Makerspace-Ashoka/plotter/README.md

# Building a Pen Plotter

Refer to the [blog here.](https://shivamkedia17.github.io/plotter)

This repo contains:
- stepper + driver + CNC shield test code, 
- CAD files (STEP + STL)
- CAD references (obtained from GrabCAD)
- [List of Parts](parts_list.md)
