Makerspace-Ashoka/plotter/index.md

---
title: Plotter Assembly
<!-- layout: base -->
---

Please refer to the relevant sections below:
- [Assembly Walkthrough](tutorial.md)
- [Hurdles](roadblocks.md)
- [What I did & what I learnt](reasoning.md)

# Video Demo

[Here's how](https://youtu.be/HApuH0hwS18) the machine looks when writing a simple G-Code file containing "abc 123 ABC".

# Build Timelapse
Here's a timelapse stitched together to cover almost the entire assembly process. I ended up not recording the parts where I had to troubleshoot, simply because I was trying to figure out what was going wrong.

Please find the [video here](https://youtu.be/O-tHqOsZ5go).
