Makerspace-Ashoka/plotter/cad-references/arduino-129.snapshot.11/Arduino Uno R3 Italy - Bottom view.png

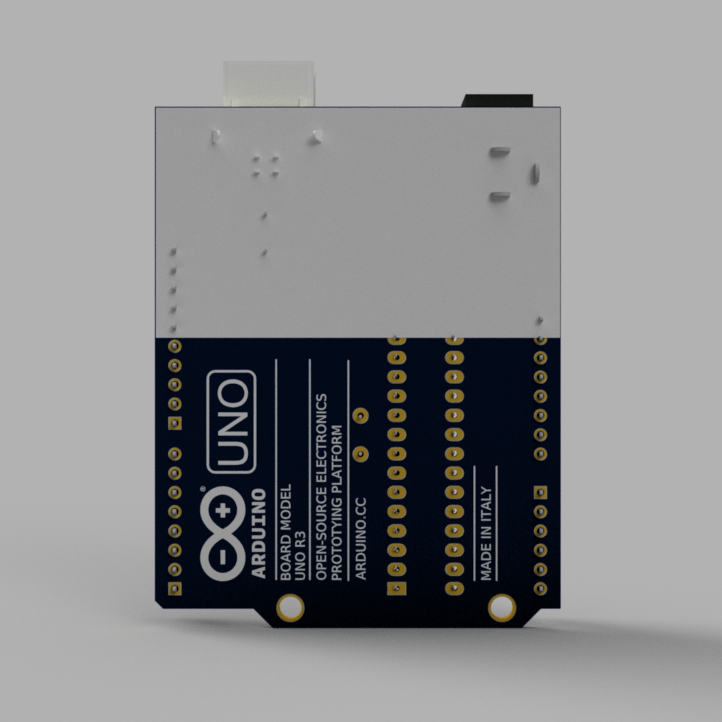
cad-references/arduino-129.snapshot.11/Arduino Uno R3 Italy - Bottom view.png
