Makerspace-Ashoka/plotter/cad-references/arduino-129.snapshot.11/ARDUINO-UNO-R3.png

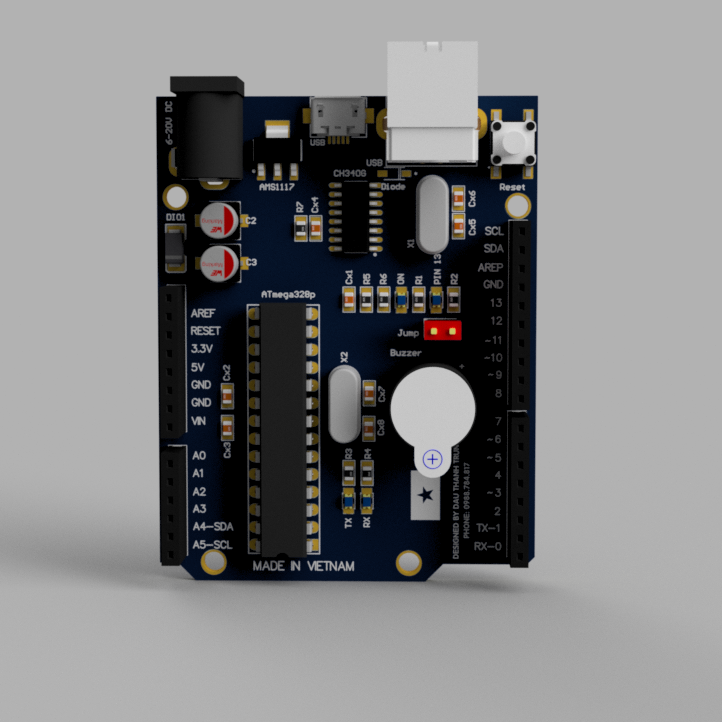
cad-references/arduino-129.snapshot.11/ARDUINO-UNO-R3.png
