Makerspace-Ashoka/plotter/cad-references/nema-17-1-1-scale-1.snapshot.3/c1f0ca76-238e-4594-b3d4-8ab40a781ef2.PNG

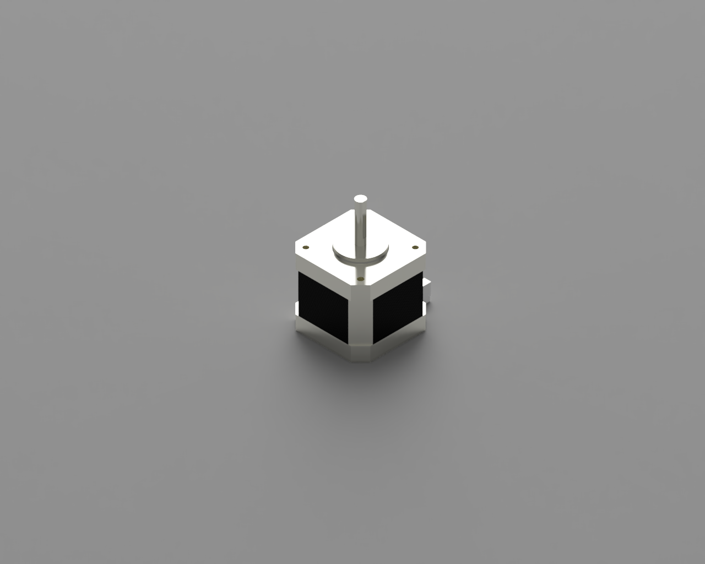
cad-references/nema-17-1-1-scale-1.snapshot.3/c1f0ca76-238e-4594-b3d4-8ab40a781ef2.PNG
