Makerspace-Ashoka/plotter/cad-references/nema-17-1-1-scale-1.snapshot.3/Nema_17_11_2024-Feb-22_08-42-41PM-000_CustomizedView2567685972.png

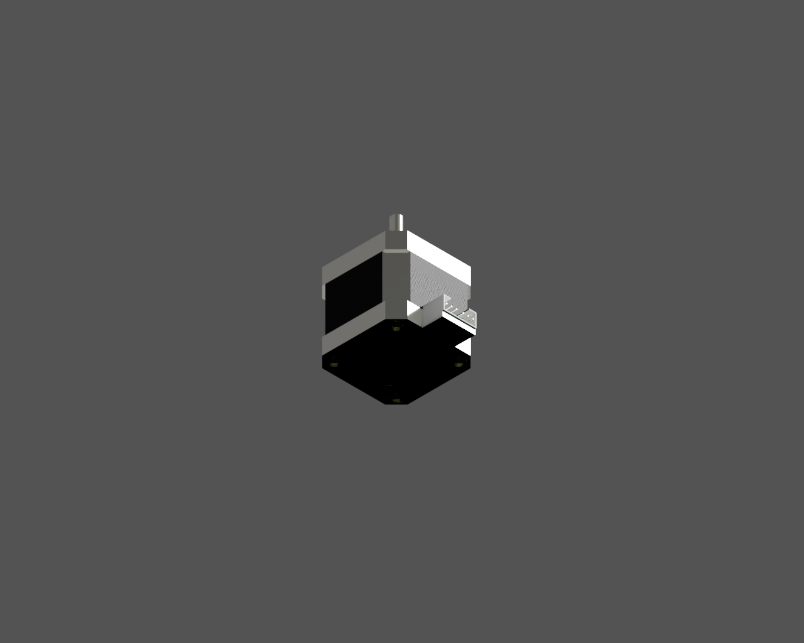
cad-references/nema-17-1-1-scale-1.snapshot.3/Nema_17_11_2024-Feb-22_08-42-41PM-000_CustomizedView2567685972.png
