Makerspace-Ashoka/plotter/cad-references/nema-17-1-1-scale-1.snapshot.3/Screenshot 2024-02-22 154305.png

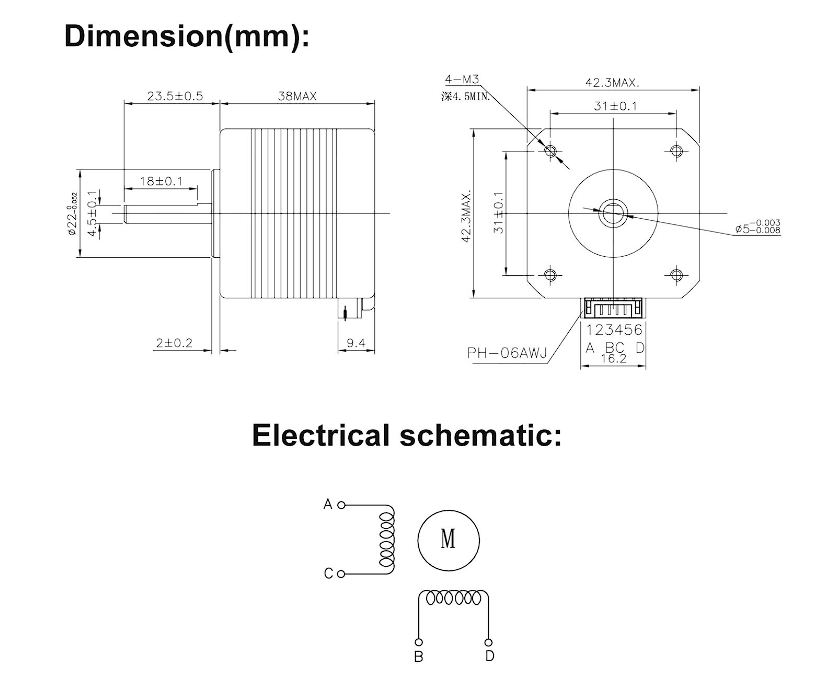
cad-references/nema-17-1-1-scale-1.snapshot.3/Screenshot 2024-02-22 154305.png
