Makerspace-Ashoka/plotter/photos/blog-bg.jpeg

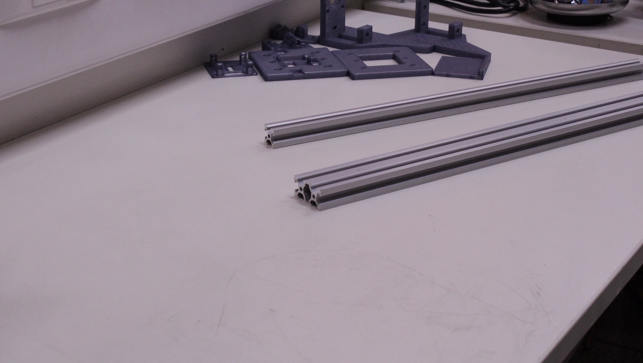
photos/blog-bg.jpeg
