Makerspace-Ashoka/plotter/cad-references/gantry-assembly-1.snapshot.1/Gantry Assembly v6.step

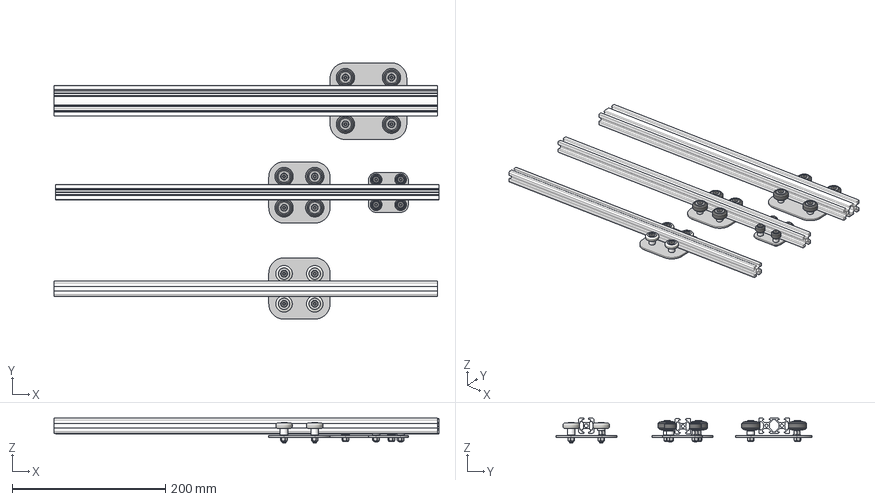
[picture p12: CAD file, 2024-05-11]
cad-references/gantry-assembly-1.snapshot.1/Gantry Assembly v6.step
502.0 x 334.2 x 32.5 mm
Nylon Insert Lock Nut M5 (1) (1) x 16
Aluminum Spacer 6mm (1) (1) (1) x 6
Precision Shim 8 x 5 x 1 (1) (1) x 16
Solid V Wheel (1) (1) x 8
Ball Bearing 5 x 16 x 5 (2) (1) x 8
Precision Shim 10 x 5 x 1 (1) (1) x 8
Ball Bearing 5 x 16 x 5 (1) (1) (1) x 8
Low profile screw M5 (1) (1) (1) x 16
Mini Eccentric Spacer 6mm x 8
Delrin Mini V Wheel (1) x 4
Ball Bearing 5 x 10 x 4.2 x 4
Ball Bearing 5 x 10 x 4.2 (2) x 4
Precision Shim 8 x 5 x 1 x 4
VSlot 2020 500mm
VSlot 2040
Profile 2020
625zz 5x16x5mm x 4
Aluminum Spacer 9mm x 2
Aluminum Spacer 3mm x 2
