Makerspace-Ashoka/plotter/cad-references/2020-v-slot-10-1500mm-length-v-slot-1.snapshot.3/vslot 2020.STEP

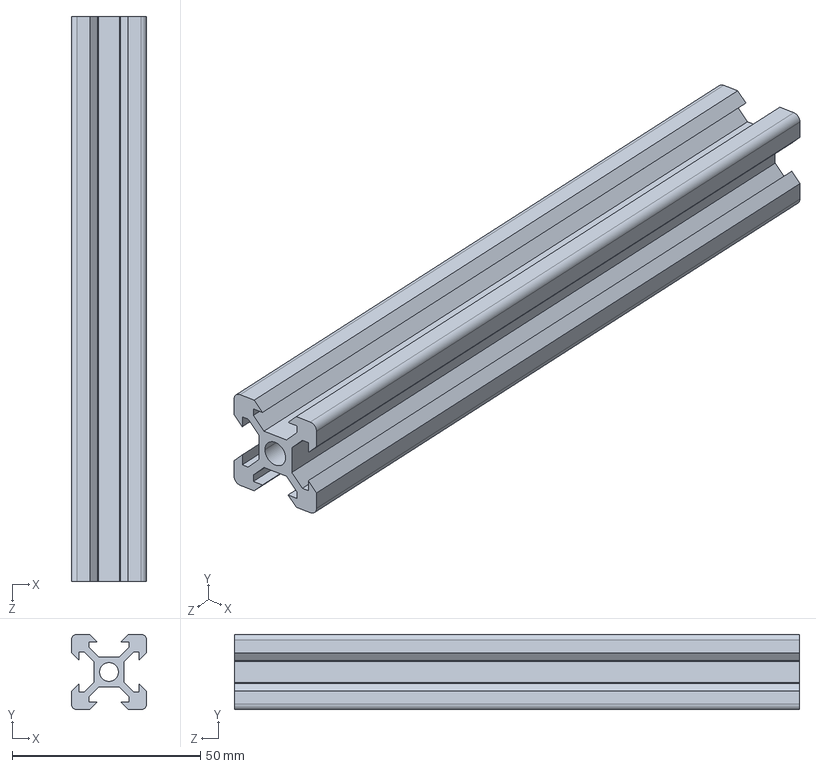
[picture p13: CAD file, 2024-05-11]
cad-references/2020-v-slot-10-1500mm-length-v-slot-1.snapshot.3/vslot 2020.STEP
20.0 x 20.0 x 150.0 mm
