Makerspace-Ashoka/plotter/cad-references/mg90s-servo-2.snapshot.1/MG90S Servo-Wing.step

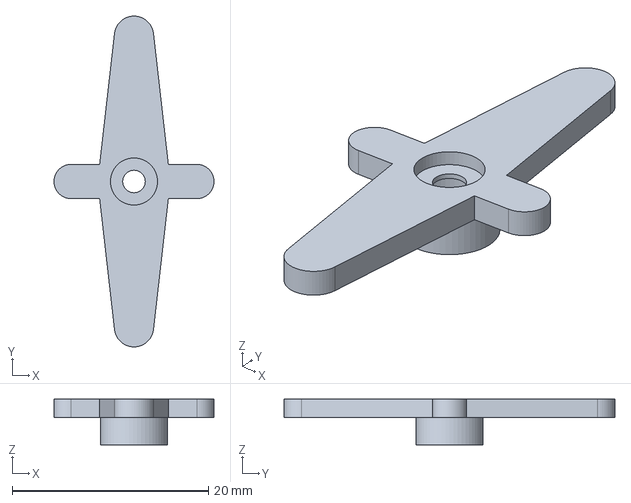
[picture p14: CAD file, 2024-05-11]
cad-references/mg90s-servo-2.snapshot.1/MG90S Servo-Wing.step
16.3 x 33.7 x 4.65 mm
MG90S_Wing_A_Body
LCS_MH_center
