Makerspace-Ashoka/plotter/cad-references/nema-17-1-1-scale-1.snapshot.3/Nema 17.step

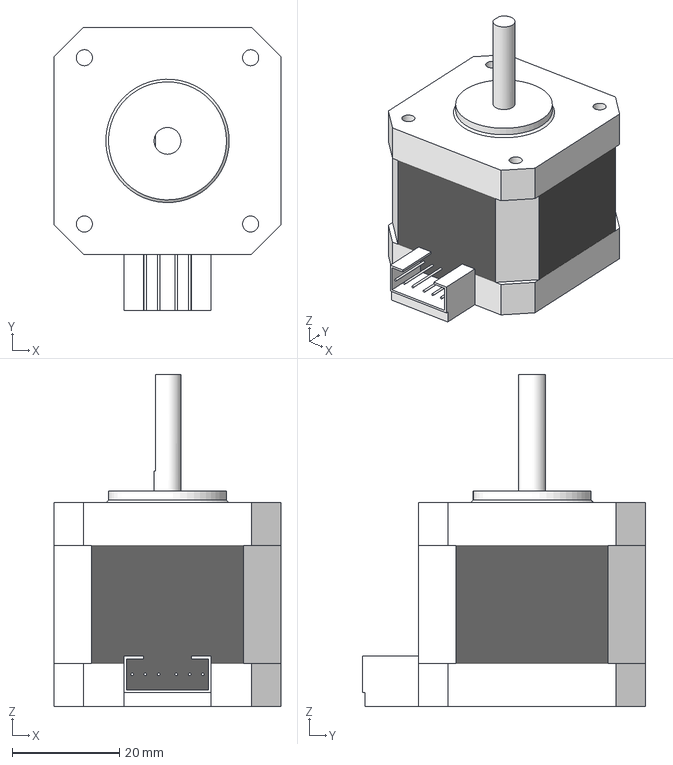
[picture p15: CAD file, 2024-05-11]
cad-references/nema-17-1-1-scale-1.snapshot.3/Nema 17.step
42.3 x 52.8 x 61.9 mm
