Makerspace-Ashoka/plotter/cad-references/pulley-gt2-20-tooth-5-bore-gt2-1.snapshot.1/Шкив GT2 20T b5.SLDPRT

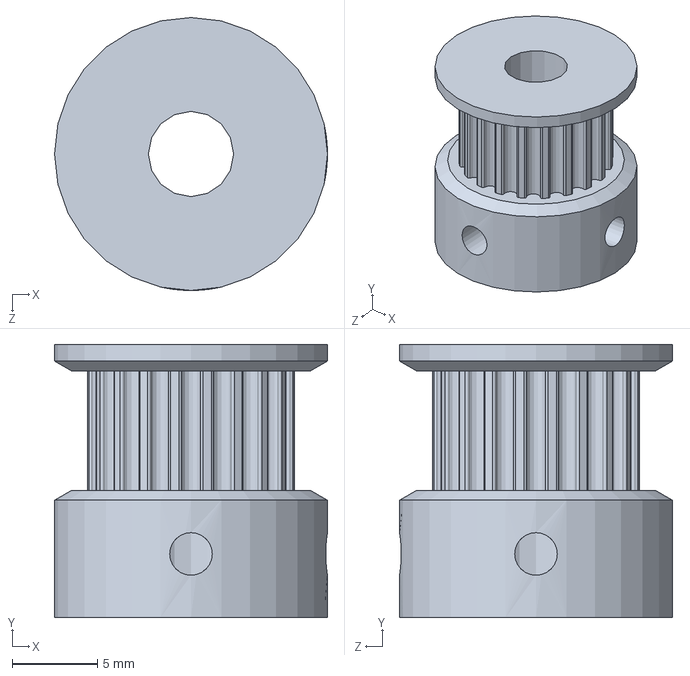
[picture p16: CAD file, 2024-05-11]
cad-references/pulley-gt2-20-tooth-5-bore-gt2-1.snapshot.1/Шкив GT2 20T b5.SLDPRT
16.0 x 16.0 x 16.0 mm
