Makerspace-Ashoka/plotter/step-files/individual parts/extra-spacer.step

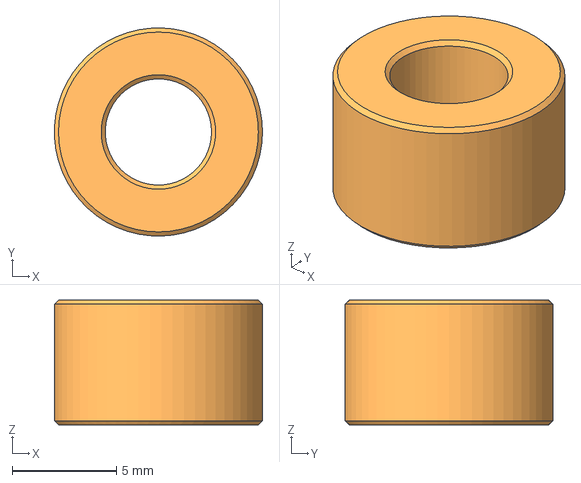
[picture p17: CAD file, 2024-04-30]
step-files/individual parts/extra-spacer.step
9.99 x 10.00 x 6.00 mm
