Makerspace-Ashoka/plotter/stl-files/custom gantry 2040 - 2040 gantry x-ax back.stl

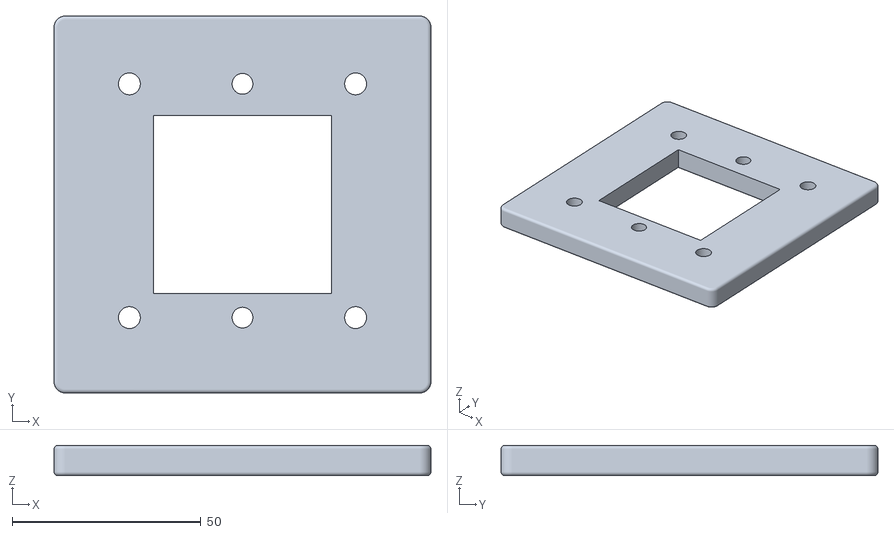
[picture p18: CAD file, 2024-05-11]
stl-files/custom gantry 2040 - 2040 gantry x-ax back.stl
100.0 x 100.0 x 8.00
