Makerspace-Ashoka/plotter/cad-references/mg90s-servo-2.snapshot.1/MG90S Servo-All.step

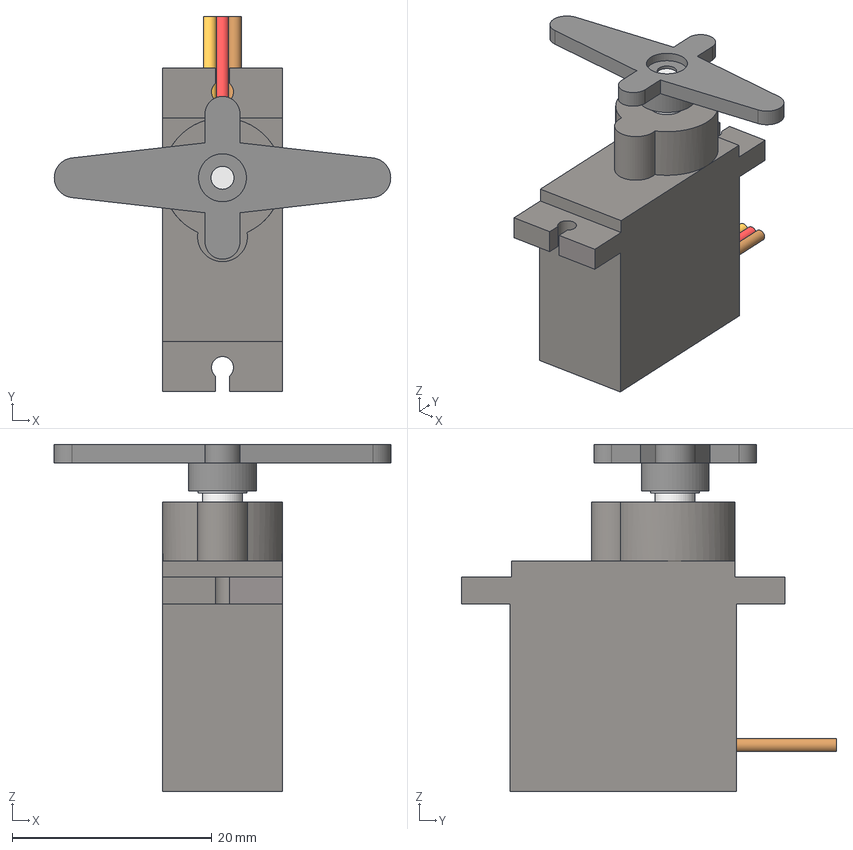
[picture p19: CAD file, 2024-05-11]
cad-references/mg90s-servo-2.snapshot.1/MG90S Servo-All.step
33.7 x 37.5 x 34.8 mm
LCS_Origin x 5
MG90SBody
MG90S_Wing_A_Body
