Makerspace-Ashoka/plotter/step-files/individual parts/y axis mounts - idler mount.step

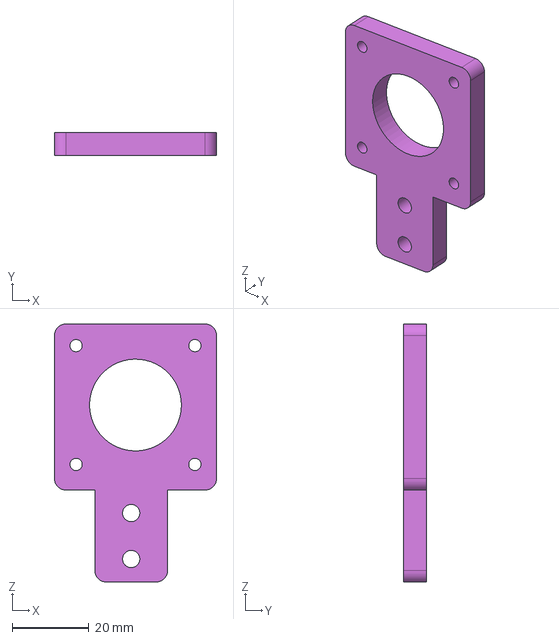
[picture p20: CAD file, 2024-04-29]
step-files/individual parts/y axis mounts - idler mount.step
42.3 x 6.00 x 67.3 mm
