Makerspace-Ashoka/plotter/step-files/y axis mounts.step

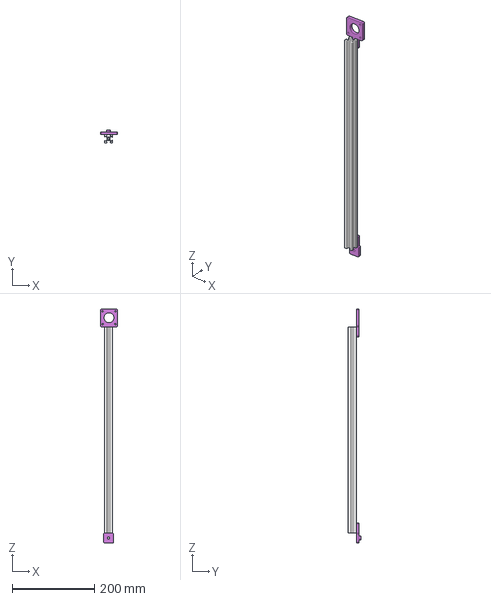
[picture p21: CAD file, 2024-05-11]
step-files/y axis mounts.step
42.3 x 31.0 x 567.3 mm
