Makerspace-Ashoka/plotter/stl-files/Feet - right foot.stl

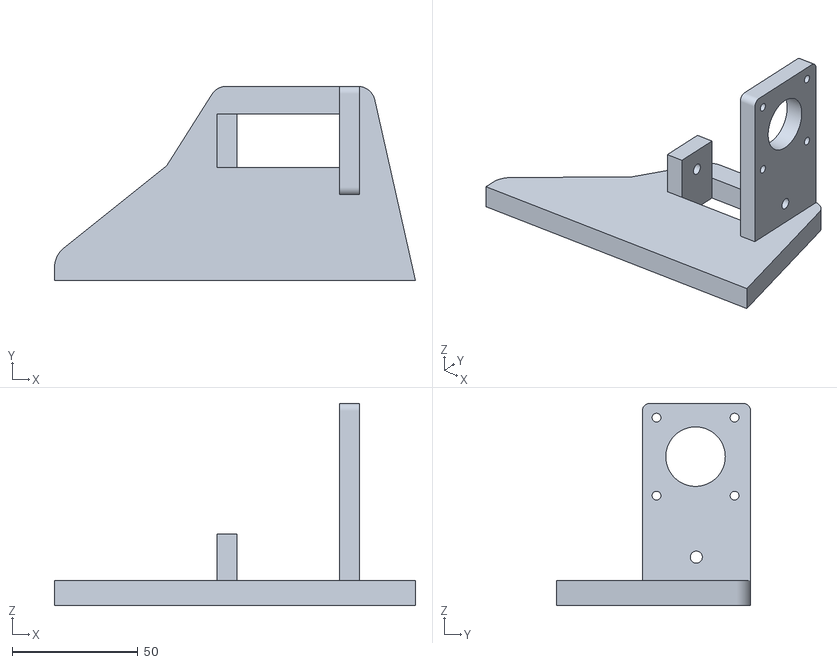
[picture p22: CAD file, 2024-05-11]
stl-files/Feet - right foot.stl
143.4 x 77.2 x 80.3
