Makerspace-Ashoka/plotter/cad-references/mg90s-servo-2.snapshot.1/MG90S Servo.step

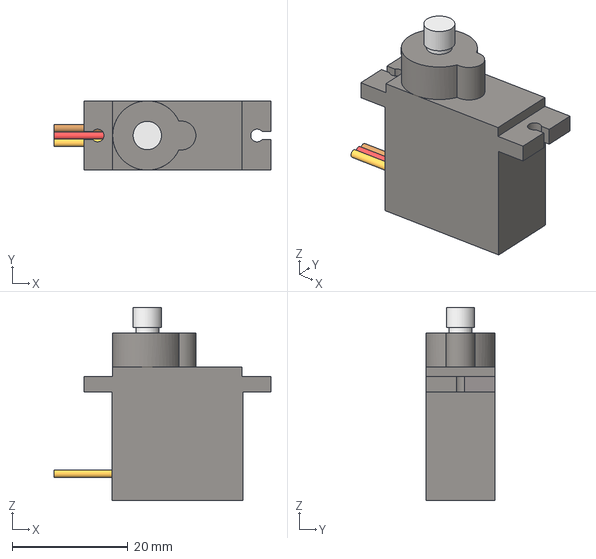
[picture p23: CAD file, 2024-05-11]
cad-references/mg90s-servo-2.snapshot.1/MG90S Servo.step
37.5 x 12.0 x 33.4 mm
MG90SBody
LCS_Shaft_top x 3
