Makerspace-Ashoka/plotter/step-files/custom gantry 2040.step

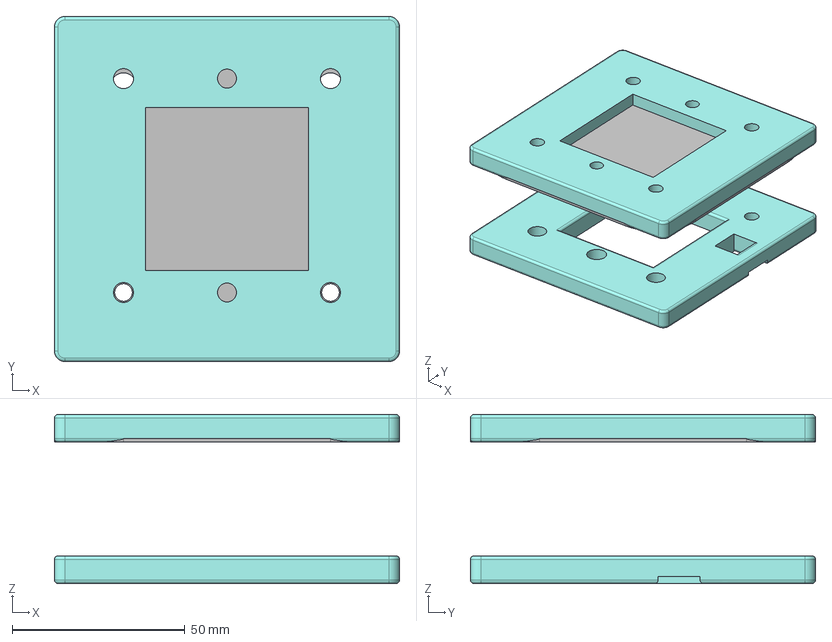
[picture p24: CAD file, 2024-05-11]
step-files/custom gantry 2040.step
100.0 x 100.0 x 49.0 mm
