Makerspace-Ashoka/plotter/stl-files/y axis mounts - stepper mount y-ax.stl

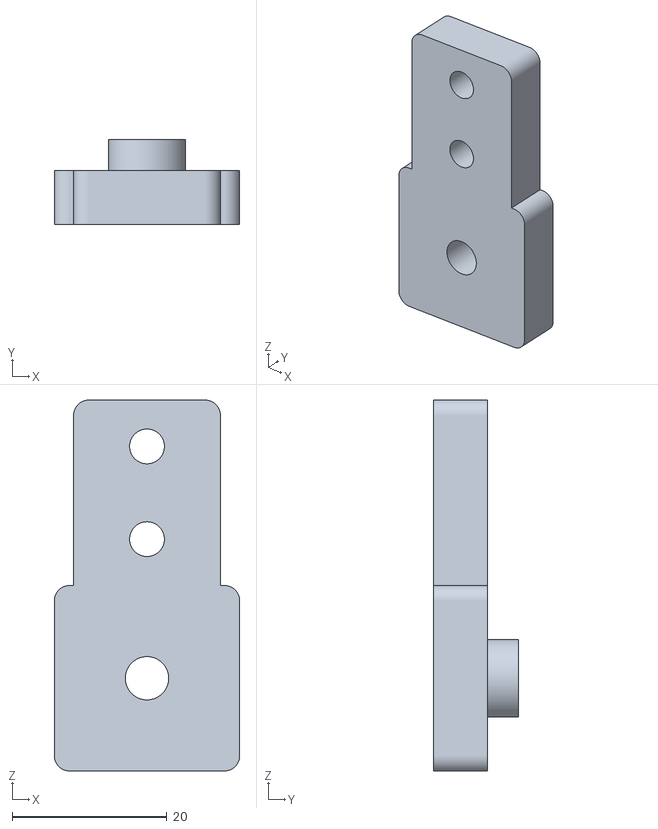
[picture p25: CAD file, 2024-05-11]
stl-files/y axis mounts - stepper mount y-ax.stl
24.0 x 11.0 x 48.0
