Makerspace-Ashoka/plotter/step-files/Feet.step

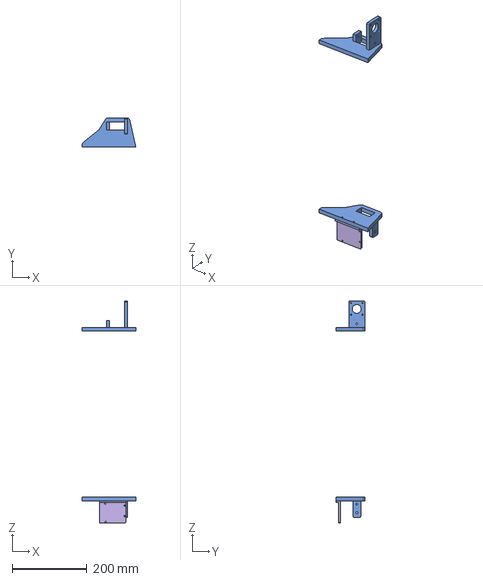
[picture p26: CAD file, 2024-05-11]
step-files/Feet.step
143.4 x 77.2 x 592.4 mm
