Makerspace-Ashoka/plotter/stl-files/Feet - arduino plate.stl

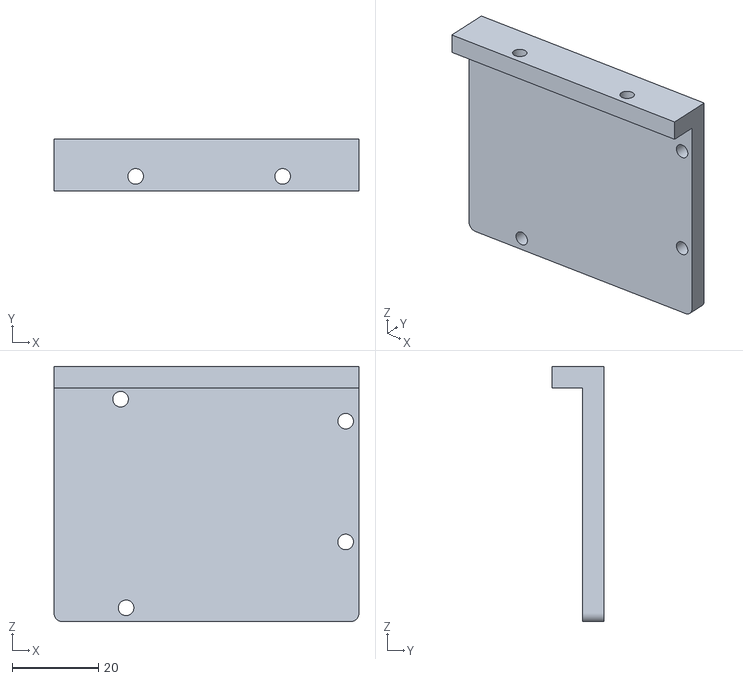
[picture p27: CAD file, 2024-05-11]
stl-files/Feet - arduino plate.stl
70.6 x 12.0 x 59.1
