Makerspace-Ashoka/plotter/step-files/y axis gantry + pen lifter.step

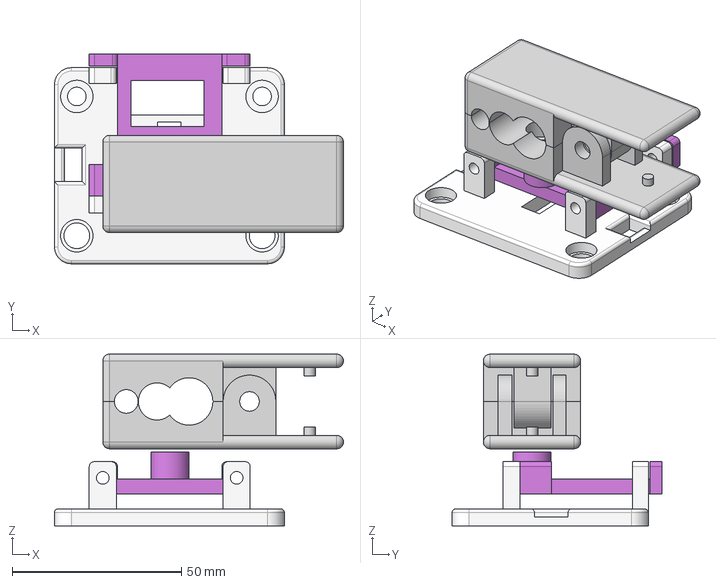
[picture p28: CAD file, 2024-05-11]
step-files/y axis gantry + pen lifter.step
85.5 x 62.0 x 50.8 mm
