Makerspace-Ashoka/plotter/stl-files/pen lifter - pen clip fixed.stl

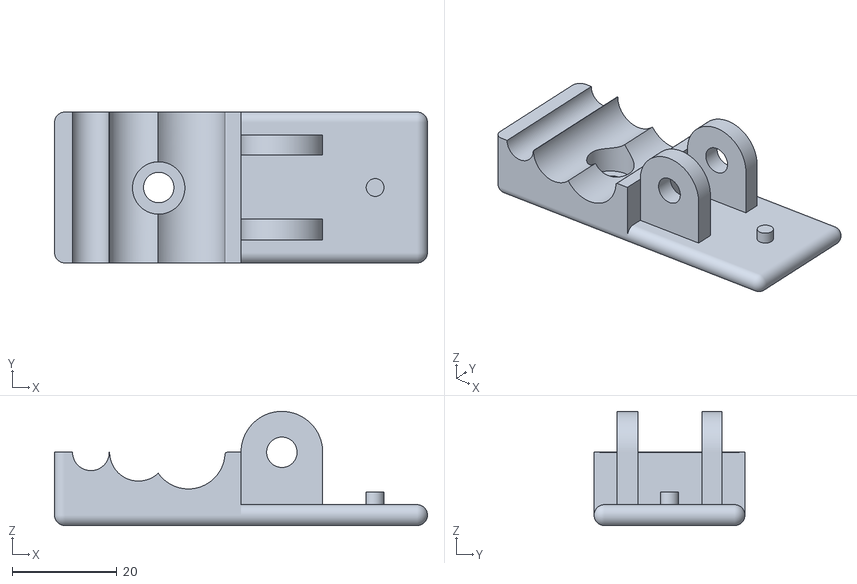
[picture p29: CAD file, 2024-05-11]
stl-files/pen lifter - pen clip fixed.stl
71.2 x 28.8 x 21.8
