Makerspace-Ashoka/plotter/stl-files/y axis mounts - idler mount y-ax.stl

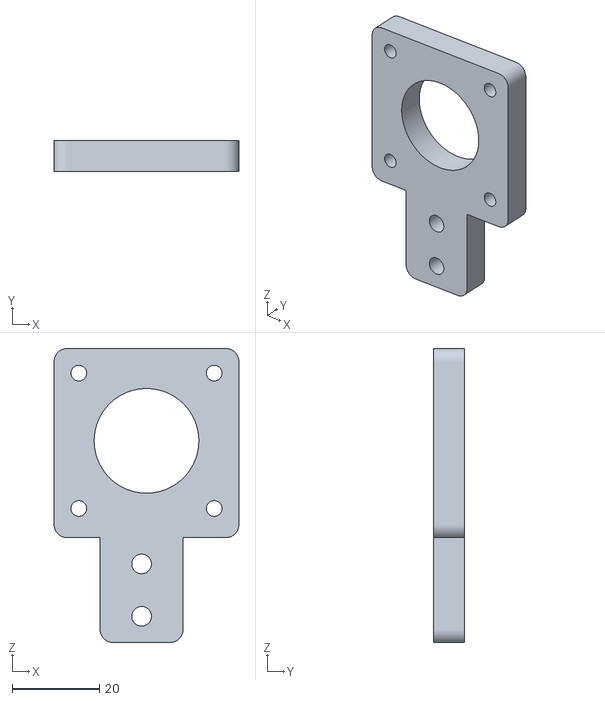
[picture p30: CAD file, 2024-05-11]
stl-files/y axis mounts - idler mount y-ax.stl
42.3 x 7.00 x 67.3
