Makerspace-Ashoka/plotter/stl-files/pen lifter - Pen lifter.stl

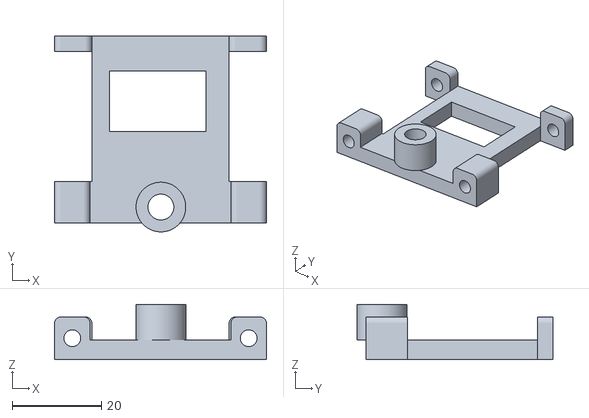
[picture p31: CAD file, 2024-05-11]
stl-files/pen lifter - Pen lifter.stl
47.6 x 44.0 x 12.4
