Makerspace-Ashoka/plotter/stl-files/Feet - left foot.stl

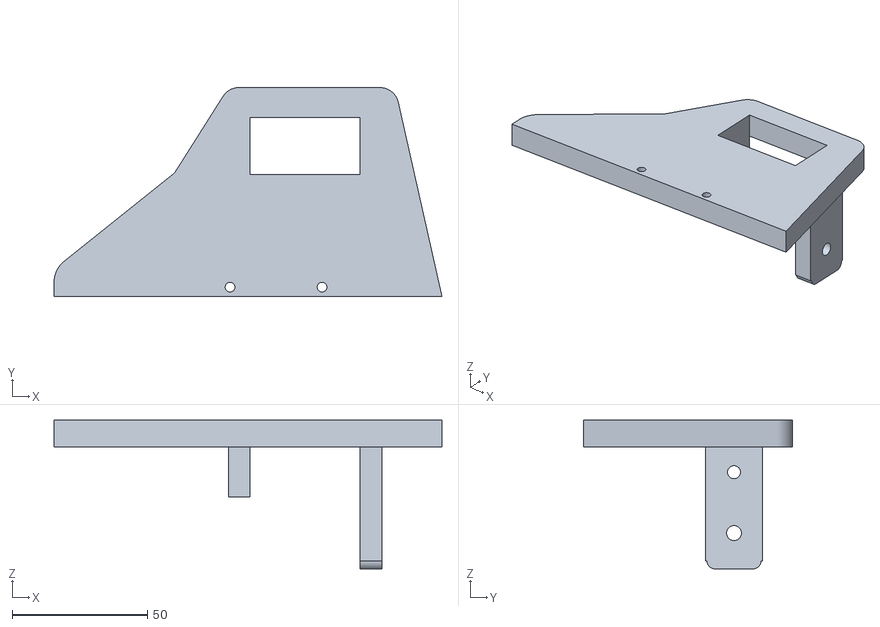
[picture p33: CAD file, 2024-05-11]
stl-files/Feet - left foot.stl
143.4 x 77.2 x 55.0
