Makerspace-Ashoka/plotter/stl-files/2020 gantry y-ax.stl

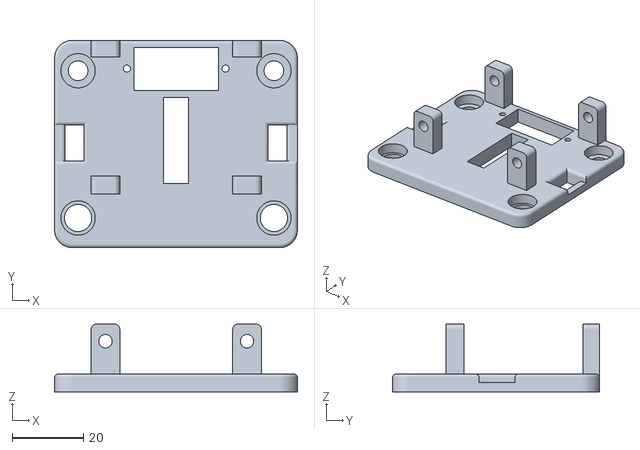
[picture p34: CAD file, 2024-05-11]
stl-files/2020 gantry y-ax.stl
68.0 x 58.0 x 19.0
