Makerspace-Ashoka/plotter/(list of files, cad)

Other CAD files:
step-files/Spacer.step
cad-references/2020-v-slot-10-1500mm-length-v-slot-1.snapshot.3/Профиль V-slot 20x20.SLDPRT
cad-references/nema-17-1-1-scale-1.snapshot.3/Nema 17 1 to 1 scale.stl
cad-references/pulley-gt2-20-tooth-5-bore-gt2-1.snapshot.1/gt2 20b5.STEP
cad-references/gantry-assembly-1.snapshot.1/Gantry Assembly v6.f3d
cad-references/mg90s-servo-2.snapshot.1/MG90S Servo.FCStd
cad-references/nema-17-1-1-scale-1.snapshot.3/Nema 17 1 to 1 scale.f3d
cad-references/nema-17-1-1-scale-1.snapshot.3/Nema 17 1 to 1 scale.obj
stl-files/spacer.stl
