Makerspace-Ashoka/plotter/cad-references/gantry-assembly-1.snapshot.1/Gantry Assembly v6.png

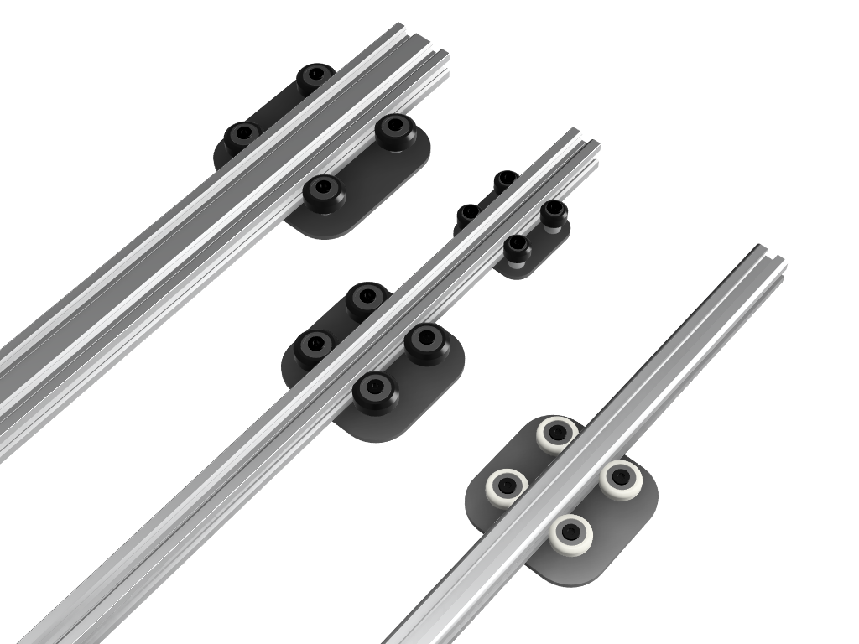
cad-references/gantry-assembly-1.snapshot.1/Gantry Assembly v6.png
