Makerspace-Ashoka/plotter/photos/3d print - tools.jpeg

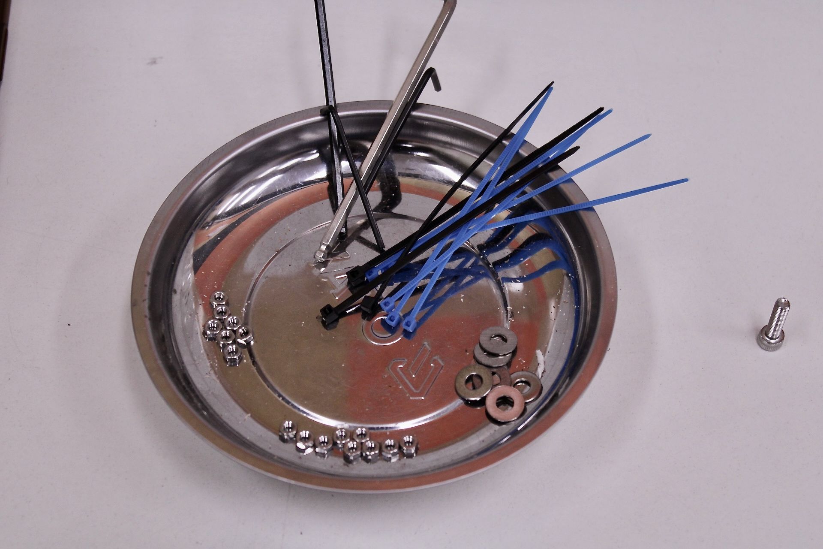
photos/3d print - tools.jpeg
