Makerspace-Ashoka/plotter/(commit log)

2024-04-28 blog+ online, cad, assembly outline
2024-04-29 add step, stl files
    [2020 gantry y-ax.step, 2040 gantry x-ax back.step, 2040 gantry x-ax front.step, Feet.step, Pen clip (fixed end).step, Pen clip (fixed end).stl, Pen lifter.stl, arduino plate.step]
2024-04-30 add step file for spacer
    [2020 gantry y-ax.step, 2040 gantry x-ax back.step, 2040 gantry x-ax front.step, Feet.step, Pen clip (fixed end).step, Pen clip (fixed end).stl, Pen lifter.stl, arduino plate.step]
2024-04-30 commit hsitory mess up?
    [2020 gantry y-ax.step, 2040 gantry x-ax back.step, 2040 gantry x-ax front.step, Feet.step, Pen clip (fixed end).step, Pen clip (fixed end).stl, Pen lifter.stl, arduino plate.step]
2024-05-11 v3 (hopefully) final
    [2020 gantry y-ax.stl, Feet - arduino plate.step, Feet - arduino plate.stl, Feet - left foot.step, Feet - left foot.stl, Feet - right foot.step, Feet - right foot.stl, Feet.step]
2024-05-15 strucutre report into 3 components
    [2020 gantry y-ax.stl, Feet - arduino plate.stl, Feet - left foot.stl, Feet - right foot.stl, Feet.step, Gantry Assembly v6.f3d, Gantry Assembly v6.step, MG90S Servo-All.step]
